brunersj/ee459-project/Scooter Control Schematic.sch

## EAGLE design Scooter Control Schematic.sch (2019-11-21)

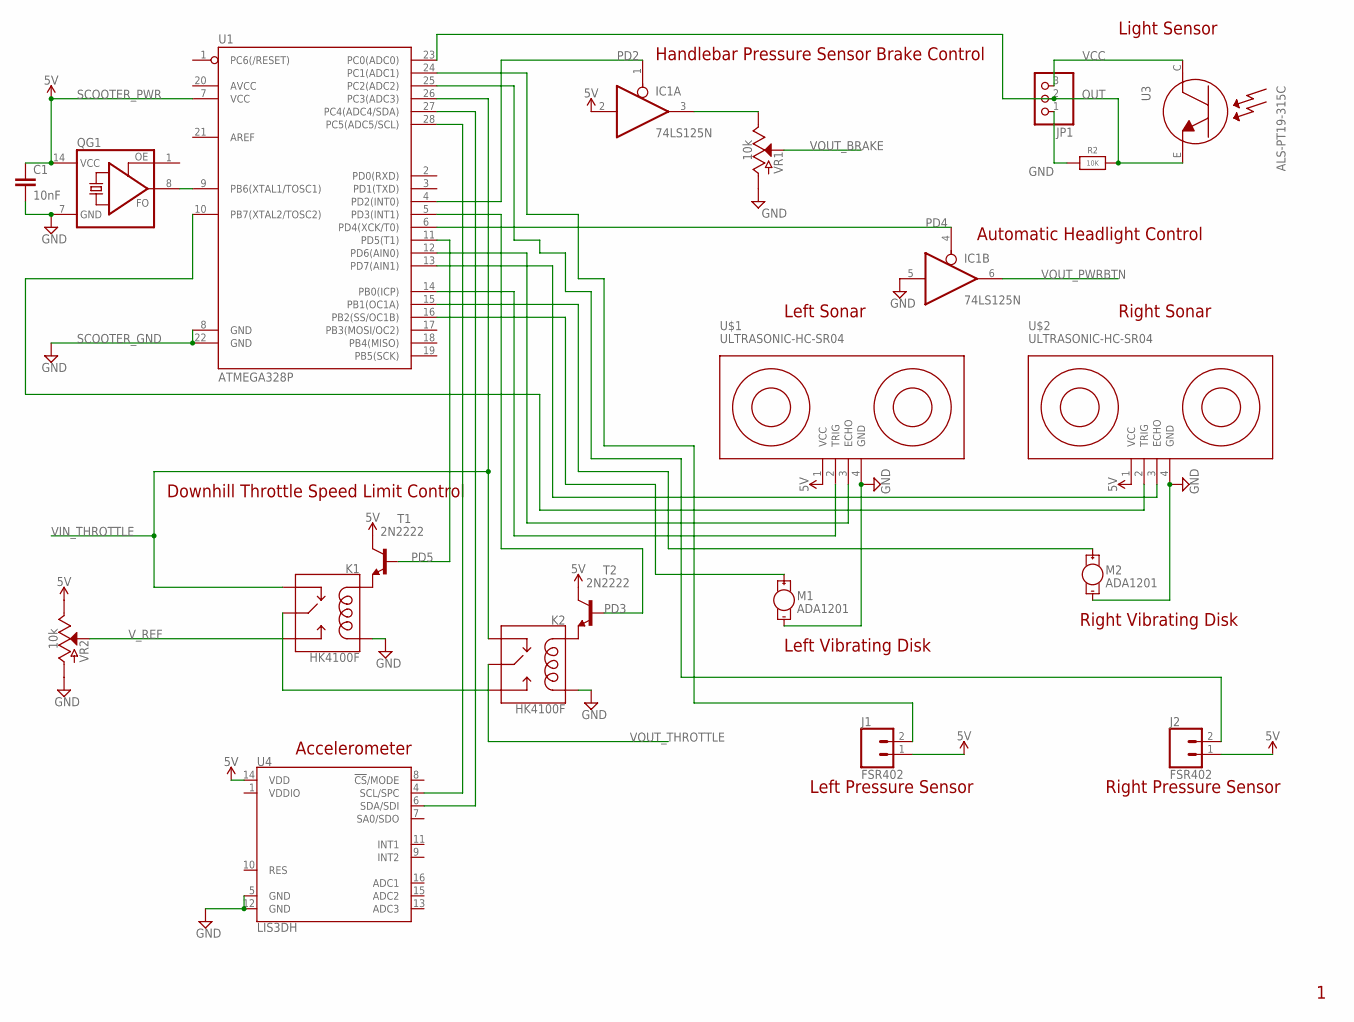
[picture p33: schematic Scooter Control Schematic.sch]

Parts:
C1: 10nF; CAP-PTH-10MM
IC1: 74LS125N; DIL14
J1, J2: FSR402; 1X02
JP1: HEADER-1X3ROUND; 1X03_ROUND
K1, K2: HK4100F; RELAY-JZC
M1, M2: ADA1201; VIBE-MOTOR-10MM
QG1: SG51
R2: 10K; 0603-NO
T1, T2: 2N2222; TO18
U1: ATMEGA328P; DIP28
U3: ALS-PT19-315C
U4: LIS3DH; LGA-16-3X3
U$1, U$2: ULTRASONIC-HC-SR04
VR1, VR2: 10k; POT-PTH-ALPS-KIT

Connections:
5V: IC1.2 (I), J1.1, J2.1, T1.3 (C), T2.3 (C), U4.14 (VDD), U$1.1 (VCC), U$2.1 (VCC), VR2.P$1 (E)
GND: C1.2, IC1.5 (I), JP1.1, K1.1 (COIL2), K2.1 (COIL2), M1.-, M2.-, QG1.7 (GND), R2.1, U4.5 (GND), U4.12 (GND), U$1.4 (GND), U$2.4 (GND), VR1.P$3 (A), VR2.P$3 (A)
unnamed: IC1.3 (O), VR1.P$1 (E)
unnamed: U1.14 (PB0(ICP)), U$1.2 (TRIG)
unnamed: U1.12 (PD6(AIN0)), U$1.3 (ECHO)
unnamed: K1.4 (MAIN), K2.3 (NO)
unnamed: K2.5 (COIL1), T2.1 (E)
unnamed: K1.5 (COIL1), T1.1 (E)
unnamed: U1.10 (PB7(XTAL2/TOSC2)), U$2.2 (TRIG)
unnamed: U1.13 (PD7(AIN1)), U$2.3 (ECHO)
unnamed: U1.28 (PC5(ADC5/SCL)), U4.4 (SCL/SPC)
unnamed: U1.27 (PC4(ADC4/SDA)), U4.6 (SDA/SDI)
unnamed: M1.+, U1.16 (PB2(SS/OC1B))
unnamed: M2.+, U1.15 (PB1(OC1A))
unnamed: J1.2, U1.24 (PC1(ADC1))
unnamed: J2.2, U1.25 (PC2(ADC2))
unnamed: QG1.8 (FO), U1.9 (PB6(XTAL1/TOSC1))
OUT: JP1.2, R2.2, U1.23 (PC0(ADC0)), U3.E
PD2: IC1.1 (OE), U1.4 (PD2(INT0))
PD3: T2.2 (B), U1.5 (PD3(INT1))
PD4: IC1.4 (OE), U1.6 (PD4(XCK/T0))
PD5: T1.2 (B), U1.11 (PD5(T1))
SCOOTER_GND: U1.8 (GND), U1.22 (GND)
SCOOTER_PWR: C1.1, QG1.14 (VCC), U1.7 (VCC)
VCC: JP1.3, U3.C
VIN_THROTTLE: K1.2 (NC), K2.2 (NC), U1.26 (PC3(ADC3))
VOUT_BRAKE: VR1.P$2 (S)
VOUT_PWRBTN: IC1.6 (O)
VOUT_THROTTLE: K2.4 (MAIN)
V_REF: K1.3 (NO), VR2.P$2 (S)

Notes on the sheet:
Automatic Headlight Control
Handlebar Pressure Sensor Brake Control
Downhill Throttle Speed Limit Control
Light Sensor
Left Sonar
Right Sonar
Accelerometer
Left Vibrating Disk
Right Vibrating Disk
Left Pressure Sensor
Right Pressure Sensor
